callumrst/OpenHaldex-T4/Documents & Notes/92d4ecdb-a1d0-4684-9f06-b1b2331b5a30.jpg

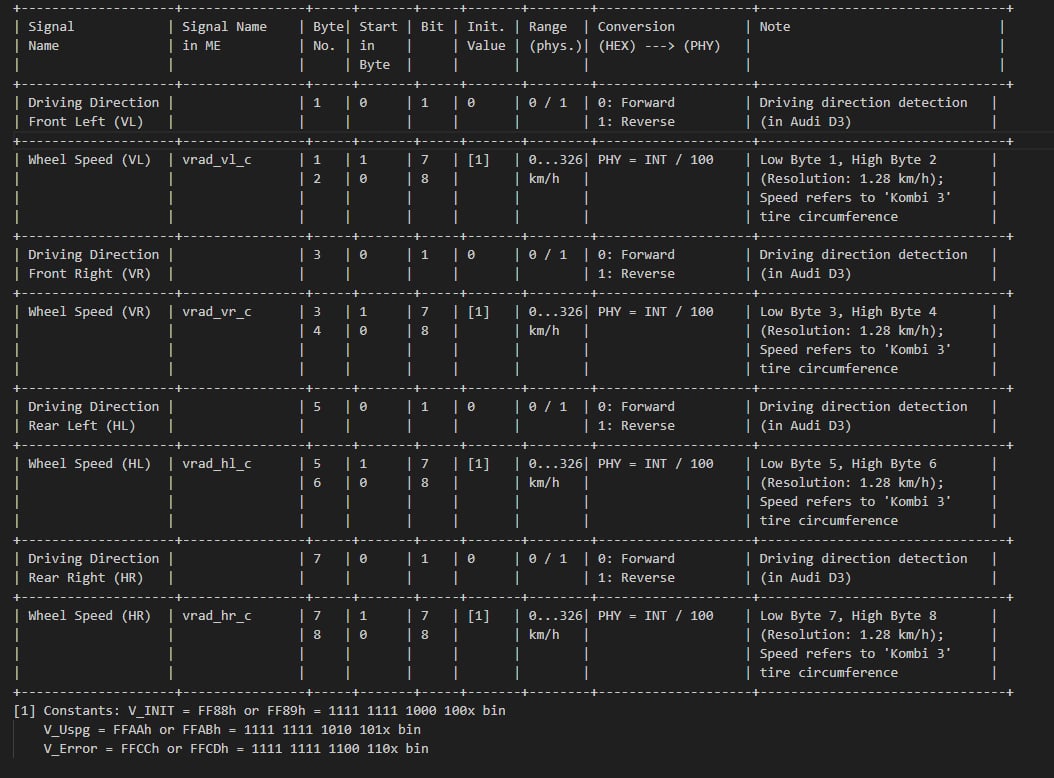
Documents & Notes/92d4ecdb-a1d0-4684-9f06-b1b2331b5a30.jpg
