callumrst/OpenHaldex-T4/README.md

# OpenHaldex - V3 dev fork

This is purely a development fork - do not upload to your Haldex Controller.
