callumrst/OpenHaldex-T4/Documents & Notes/IMG_9825.thumb.png.15f37aaaf69d263c4d689f1573d7c5fc.png

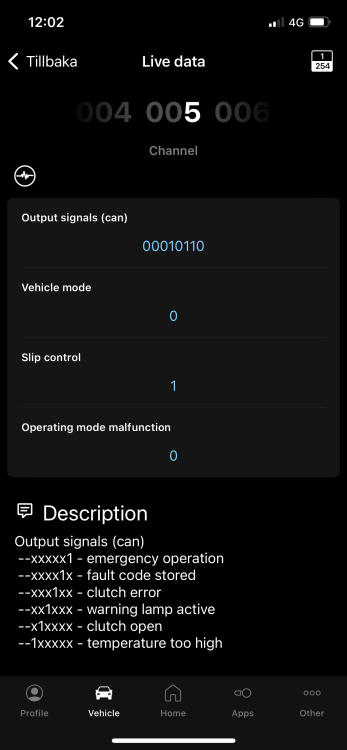
Documents & Notes/IMG_9825.thumb.png.15f37aaaf69d263c4d689f1573d7c5fc.png
