callumrst/OpenHaldex-T4/Documents & Notes/MKV GTI CAN-BUS data.xlsx

Sheet: Example Traces
Action Sample Time | Relative time |  | ID (hex) | DLC | D0 B1 | D1 B2 | D2 B3 | D3 B4 | D4 B5 | D5 B6 | D6 B7 | D7 B8 | Comments |  | Protocol decode
Radio off to on
0.006 | 0.000 | 680 | 1 | A3 |  |  |  |  |  |  |  |  |  | Channel parameters
0.018 | 0.012 | 681 | 6 | A1 | 04 | 8A | FF | 32 | FF |  |  | ASCII: 2 | 04 | number of packets until ACK
1.495 | 1.489 | 680 | 1 | A3 |  |  |  |  |  |  |  |  | 0x8AFF, 0x32FF | TP2.0 timming parameters
1.496 | 1.490 | 681 | 6 | A1 | 04 | 8A | FF | 32 | FF |  |  | ASCII: 2
2.899 | 2.893 | 680 | 8 | 20 | 02 | 70 | 52 | 12 | 41 | 75 | 64 | ASCII: pR Aud | 0x52 | Radio (requester) wants to
2.901 | 2.895 | 680 | 8 | 21 | 69 | 6F | 00 | 00 | 00 | 00 | 00 | ASCII:!io | 0x02 70 | add menu to MFA+
2.902 | 2.896 | 680 | 1 | A3 |  |  |  |  |  |  |  |  | 0x12 | in the middle segment | (110x91 pixels)
2.925 | 2.919 | 680 | 7 | 12 | 00 | 00 | 00 | 00 | 00 | 00 |  | ASCII: |  | with title 'Audio'
2.946 | 2.940 | 681 | 6 | A1 | 04 | 8A | FF | 32 | FF
2.974 | 2.968 | 681 | 1 | B3
3.01 | 3.004 | 681 | 5 | 10 | 23 | 00 | 00 | 00 |  |  |  | ASCII: # | 0x23 0x00 | reply with screen area ID, 0x00 in this example
3.01 | 3.004 | 680 | 1 | B1
4.381 | 4.375 | 680 | 1 | A3
4.416 | 4.410 | 681 | 6 | A1 | 04 | 8A | FF | 32 | FF
30.921 | 30.915 | 680 | 1 | A3
30.931 | 30.925 | 681 | 6 | A1 | 04 | 8A | FF | 32 | FF
32.014 | 32.008 | 680 | 1 | A3
32.025 | 32.019 | 681 | 6 | A1 | 04 | 8A | FF | 32 | FF
Switching to the Audio page
0.475 | 0.000 | 681 | 3 | 19 | 2A | 00 |  |  |  |  |  |  |  | req to jump to menu channel/area ID 00
0.476 | 0.001 | 680 | 1 | BA
0.496 | 0.021 | 681 | 5 | 1A | 23 | 00 | 01 | 00 |  |  |  |  |  | request to send data in area ID 00
0.498 | 0.023 | 680 | 1 | BB
0.512 | 0.037 | 680 | 8 | 23 | 09 | 00 | 60 | 09 | 00 | 00 | 00 |  | 0x09 0x00 | draw into the screen area ID, 0x00 in this example |  |  | clear screen
0.521 | 0.046 | 680 | 8 | 24 | 00 | 00 | 6E | 00 | 5B | 00 | 61 |  | 0x60 | graphic rectangle block follows after params |  | 0x09 | 09 bytes until end of array
0.531 | 0.056 | 680 | 8 | 25 | 06 | 08 | 00 | 6D | 00 | 00 | 00 |  |  | dimension of rectangle: 110x91 (0x006E x 0x005B) | (110x91 pixels) |  | draw text
0.543 | 0.068 | 680 | 8 | 06 | 61 | 0F | 10 | 00 | 37 | 00 | 1E |  | 0x61 | ASCII block follows after params |  | 0x0F | 15 bytes until end of array
0.549 | 0.074 | 681 | 1 | B7 |  |  |  |  |  |  |  |  |  |  |  |  | draw text
0.553 | 0.078 | 680 | 8 | 27 | 00 | 31 | 30 | 33 | 2E | 31 | 20 | ASCII:'103.1 |  | "103.1 MHz"
0.564 | 0.089 | 680 | 8 | 28 | 4D | 48 | 7A | 61 | 0A | 00 | 00 | ASCII:(MHza | 0x61 | ASCII block follows after params |  | 0x0A | 10 bytes until end of array
0.575 | 0.100 | 680 | 8 | 29 | 03 | 00 | 47 | 00 | 46 | 4D | 02 | ASCII:)G FM | 0x46 4D | "FM" |  |  | draw text
0.585 | 0.110 | 680 | 3 | 1A | 32 | 08 |  |  |  |  |  | ASCII:2 | 0x32 | "2" |  | 0x08 | end of block arrays
0.593 | 0.118 | 681 | 1 | BB
0.604 | 0.129 | 681 | 4 | 1B | 27 | 00 | 01 |  |  |  |  | ASCII:' | 0x27 00 01 | screen area displayed successfully
0.606 | 0.131 | 680 | 1 | BC
0.682 | 0.207 | 680 | 1 | A3
0.691 | 0.216 | 681 | 6 | A1 | 04 | 8A | FF | 32 | FF
1.766 | 1.291 | 680 | 1 | A3
1.774 | 1.299 | 681 | 6 | A1 | 04 | 8A | FF | 32 | FF
Changing radio stations on the audio page
29.316 | 0.000 | 680 | 8 | 23 | 09 | 00 | 60 | 09 | 00 | 00 | 00 | ASCII:# ` | 0x09 0x00 | draw into the screen area ID, 0x00 in this example |  |  | clear screen
29.327 | 0.011 | 680 | 8 | 24 | 00 | 00 | 6E | 00 | 5B | 00 | 61 | ASCII:$ n [ a | 0x60 | graphic rectangle block follows after params |  | 0x09 | 09 bytes until end of array
29.338 | 0.022 | 680 | 8 | 25 | 06 | 08 | 00 | 6D | 00 | 00 | 00 |  |  | dimension of rectangle: 110x91 (0x006E x 0x005B) | (110x91 pixels) |  | draw text
29.35 | 0.034 | 680 | 8 | 06 | 61 | 0F | 10 | 00 | 37 | 00 | 1E |  | 0x61 | ASCII block follows after params |  | 0x0F | 15 bytes until end of array
29.36 | 0.044 | 681 | 1 | B7 |  |  |  |  |  |  |  |  |  |  |  |  | draw text
29.37 | 0.054 | 680 | 8 | 27 | 00 | 31 | 30 | 32 | 2E | 33 | 20 | ASCII:' 102.3 |  | "102.3 MHz"
29.381 | 0.065 | 680 | 8 | 28 | 4D | 48 | 7A | 61 | 0A | 00 | 00 | ASCII:(MHza | 0x61 | ASCII block follows after params |  | 0x0A | 10 bytes until end of array
29.392 | 0.076 | 680 | 8 | 29 | 03 | 00 | 47 | 00 | 46 | 4D | 02 | ASCII:) G FM | 0x46 4D | "FM" |  |  | draw text
29.402 | 0.086 | 680 | 3 | 1A | 32 | 08 |  |  |  |  |  | ASCII: 2 | 0x32 | "2" |  | 0x08 | end of block arrays
29.414 | 0.098 | 681 | 1 | BB
29.424 | 0.108 | 680 | 1 | A3
29.436 | 0.120 | 681 | 6 | A1 | 04 | 8A | FF | 32 | FF
29.448 | 0.132 | 681 | 4 | 1D | 27 | 00 | 01 |  |  |  |  |  | 0x27 00 01 | screen area displayed successfully
29.456 | 0.140 | 680 | 1 | BE
29.555 | 0.239 | 680 | 8 | 2B | 09 | 00 | 60 | 09 | 00 | 00 | 00 | ASCII:+ ` |  |  |  |  | clear screen
29.565 | 0.249 | 680 | 8 | 2C | 00 | 00 | 6E | 00 | 5B | 00 | 61 | ASCII:, n [ a |  | dimension of rectangle: 110x91 (0x006E x 0x005B) | (110x91 pixels) |  | draw text
29.576 | 0.260 | 680 | 8 | 2D | 06 | 08 | 00 | 6D | 00 | 00 | 00 | ASCII:- m
29.587 | 0.271 | 680 | 8 | 0E | 61 | 0F | 10 | 00 | 37 | 00 | 1E | ASCII: a 7
29.598 | 0.282 | 681 | 1 | BF
29.608 | 0.292 | 680 | 8 | 2F | 00 | 31 | .. | 33 | 2E | 31 | 20 | ASCII:/ 103.1 |  |  |  | 0x0A | 10 bytes until end of array
29.62 | 0.304 | 680 | 8 | 20 | 4D | 48 | .. | 61 | 0A | 00 | 00 | ASCII: MHza |  |  |  |  | draw text
29.63 | 0.314 | 680 | 8 | 21 | 03 | 00 |  | 00 | 46 | 4D | 02 | ASCII:! G FM
29.642 | 0.326 | 680 | 3 | 12 | 32 | 08 |  |  |  |  |  | ASCII: 2 |  |  |  | 0x08 | end of block arrays
29.652 | 0.336 | 681 | 1 | B3 |  |  |  |  |  |  |  | ASCII:
29.685 | 0.369 | 681 | 4 | 1E | 27 | 00 | 01 |  |  |  |  | ASCII: ' | 0x27 00 01 | screen area displayed successfully
29.695 | 0.379 | 680 | 1 | BF |  |  |  |  |  |  |  | ASCII:
29.825 | 0.509 | 680 | 8 | 23 | 09 | 00 | 60 | 09 | 00 | 00 | 00 | ASCII:# ` |  |  |  |  | clear screen
29.836 | 0.520 | 680 | 8 | 24 | 00 | 00 | 6E | 00 | 5B | 00 | 61 | ASCII:$ n [ a |  |  |  |  | draw text
29.847 | 0.531 | 680 | 8 | 25 | 06 | 08 | 00 | 6D | 00 | 00 | 00 | ASCII:% m
 |  |  |  |  | ... | ... | ... | ... | ... | ...

Sheet: ASCII-hex conversion table
ASCII | Hex | ASCII | Hex | Comments
A | 0x41 | a | 0x61
B | 0x42 | b | 0x62
C | 0x43 | c | 0x63
D | 0x44 | d | 0x64
E | 0x45 | e | 0x65
F | 0x46 | f | 0x66
G | 0x47 | g | 0x67
H | 0x48 | h | 0x68
I | 0x49 | i | 0x69
J | 0x4A | j | 0x6A
K | 0x4B | k | 0x6B
L | 0x4C | l | 0x6C
M | 0x4D | m | 0x6D
N | 0x4E | n | 0x6E
O | 0x4F | o | 0x6F
P | 0x50 | p | 0x70
Q | 0x51 | q | 0x71
R | 0x52 | r | 0x72
S | 0x53 | s | 0x73
T | 0x54 | t | 0x74
U | 0x55 | u | 0x75
V | 0x56 | v | 0x76
W | 0x57 | w | 0x77
X | 0x58 | x | 0x78
Y | 0x59 | y | 0x79
Z | 0x5A | z | 0x7A
0 | 0x30
1 | 0x31
2 | 0x32
3 | 0x33
4 | 0x34
5 | 0x35
6 | 0x36
7 | 0x37
8 | 0x38
9 | 0x39
EOL | 0x60 0x09 |  |  | NOT, 60 09 represents 09 bytes of graphic data to be shown on Instrument Cluster
" " | 0xA0
"." | 0x2E
x

Sheet: Convenience
 | ID | DLC | Period |  | Affects device | Comment
385 | 181 | 2 | 20 | XY ZZ | TRUE | Window Buttons | X | Pass WIndows | Y | Driver WIndow | ZZ | Rear Doors
 | - | - | - | - | - | - | 1 | Up | 1 | Up
 | - | - | - | - | - | - | 2 | Auto up | 2 | Auto up
 | - | - | - | - | - | - | 4 | Down | 4 | Down
 | - | - | - | - | - | - | 8 | Auto down | 8 | Auto down
649 | 289 | 4 | 20 | 00 XX 00 00 | TRUE | Cruise Control | XX | Buttons
 | - | - | - | - | - | - | 0 | Off | 00000000
 | - | - | - | - | - | - | 1 | On | 00000001
 | - | - | - | - | - |  | 9 | Resume | 00001001
 | - | - | - | - | - | - | 5 | Set | 00000101
657 | 291 | 5 | 40 | 00 XX YY 00 00 | TRUE | Locks | XX |  | YY
 | - | - | - | - | - | - | AA | Locks doors | 04 | Unlocks trunk
 | - | - | - | - | - | - | 55 | Unlocks doors
705 | 2C1 | 5 (6?) | 100 | XX 00 00 00 00 | TRUE | Turn Signal Control | XX
 | - | - | - | - | - | - | 00010000 | Left
 | - | - | - | - | - | - | 00100000 | Right
 | - | - | - | - | - | - | 01000000 | HB forward | 40
 | - | - | - | - | - | - | 10000000 | HB back | 80
707 | 2C3 | 1 | 100 | XX 00 00 | FALSE | Ignition | XX
 | - | - | - | - | - | - | 00010000 | Key out
 | - | - | - | - | - | - | 00010001 | Key back, power on
 | - | - | - | - | - | - | 00000111 | Key on
 | - | - | - | - | - | - | 00000011 | Between on and start
 | - | - | - | - | - | - | 00001011 | Start
 | - | - | - | - | - | Diagnostic cable ID's
764 | 2FC |  |  |  |  | Steering
768 | 300 |  |  |  |  | CCM
784 | 310 |  |  |  |  | Driver Door
786 | 312 |  |  |  |  | Pass Door
808 | 328 |  |  |  |  | Conveniece
825 | 339 |  |  |  |  | Central Electronic
826 | 33A |  |  |  |  | Aux Heating
829 | 33D |  |  |  |  | HVAC
 | - | - | - | - |  | - | fsm library | (XX*(2^8)+(YY-1))/190 | 02 | Reverse
 | - | - | - | - |  | - |  |  | 00 | Forward
859 | 35B | 8 | 100 | 00 AA XX YY ZZ BB DD CC | ? | RPM, Oil temp, water Temp | XX | RPM | (YY*0.75)-64 |  | ZZ |  | Pedals | BB
 | - | - | - | - |  | - |  | (XX*(2^8)+AA)/4 |  | Water temp | ZZ | Oil temp | Clutch out | 00001000
 | - | - | - | 192 | 9 |  |  | 12290.25 |  |  |  | - | Clutch in | 00000000
 | - | - | - | - | - | - | - | - | - | - | - | - | in | 00001011
 | - | - | - | - | - | - | - | - | - | - | - | - | both | 00000011
897 | 381 | 6 | 100 | XX YY ZZ AA BB CC | TRUE | Driver Door |  | Lock | YY | Window Switch | ZZ | Windows Position | Window Status | AA | BB | Trunk/fuel | CC | Limits
 | - | - | - | - | - | - | 0000000X | Door open/closed | 00010000 | Window up | 00-C8 | Position | Open, not moving | 0 | 0 | Nothing | 1 | Top limit |  |  | 8 | Normal
 | - | - | - | - | - | - | 000000X0 | Door locked/unlocked | 100000 | Window auto up |  |  | Moving up | 1 | 1 | Fuel door release | 10 | Bottom limit |  |  | A | Pinch Detected
 | - | - | - | - | - | - | 00000100 | Lock pressed | 01000000 | Window down |  |  | Moving down | 10 | 10 | Trunk Unlock
 | - | - | - | - | - | - | 00001000 | ? | 10000000 | Window auto down |  |  | Rear Window lock? | 100 | 01000000 | Mirror heater Active?
913 | 391 | 3 | 20 | XX YY ZZ | TRUE | Key Fob | XX |  | YY |  | ZZ
 | - | - | - | - |  | - | 0 | Nothing | 0 | Nothing |  | Nothing
 | - | - | - | - |  | - | AA | Window down | 80 | Lock doors |  | Open sunroof?
 | - | - | - | - |  | - | 55 | Window up | 4 | Unlock doors |  | Close sunroof?
917 | 395 | 1 | 50 | XY | x does | Anti Theft | X |  | Y
 | - | - | - | - | - | - | 2 | ? | 1 | unlock
 | - | - | - | - | - | - | A | ? | 2 | lock
 | - | - | - | - | - | - | 8 | flash lights
949 | 3B5 | 6 | 100 | XX YY ZZ AA 00 CC | TRUE | Pass Door | xx | Lock | YY | Window Switch | ZZ | Window Position | Window Status | AA | CC | Limits
 | - | - | - | - | - | - | 0000000X | Door open/closed | 00010000 | Window up | 00-C8 | Position | Open, not moving | 0 | 1 | Top limit |  |  | 8 | Normal
 | - | - | - | - | - | - | 000000X0 | Door locked/unlocked | 100000 | Window auto up |  |  | Moving up | 1 | 10 | Bottom limit |  |  | A | Pinch Detected
 | - | - | - | - | - | - | 00000100 | Lock pressed | 01000000 | Window down |  |  | Moving down | 10
 | - | - | - | - | - | - | 10 | Unlock Pressed |  |  |  |  | ? | 1000
961 | 3C1 | 6 | 200 | XX 00 00 00 00 00 | FALSE | Steering | XX | Steering Wheel torque
963 | 3C3 | 8 | 100 | XX 00 00 00 00 00 00 00 | FALSE | Steering | XX | Steering Wheel Position
849 | 351 | 8 | ? | AA BB XX YY 00 00 00 00 | ? | Vehicle Speed | XX YY | Speed | AA | Direction
992 | 3E0 | 8 | ? | 02 00 10 00 00 00 80 00 | ? | ? | only appeared once
993 | 3E1 | 8 | 100 | XX 00 YY ZZ 00 00 AA | ? | Heater Controls? | XX |  | ZZ | AC? | ZZ | temp? | Temp? | AA
 | - | - | - | - | - | - | 20 | ? |  |  |  |  | HI | 100
 | - | - | - | - | - | 0000010 | 2 | Full hot selected |  |  |  |  | LOW | 10000000
 | - | - | - | - | - | - | 6 | rear def pressed
1136 | 470 | 5 | 50 | YY XX 00 00 00 | TRUE | Door Contacts | XX | Contacts | YY
 | - | - | - | - | - | - | 00 | Closed | 20 | Reverse gear selected
 | - | - | - | - | - | - | 01 | Drivers open
 | - | - | - | - | - | - | 02 | Pass open
 | - | - | - | - | - | - | 04 | Rear Drivers open
 | - | - | - | - | - | - | 08 | Rear pass open
 | - | - | - | - | - | - | 20 | Tailgate open
 | - | - | - | - | - | - | 10 | Hood open
1319 | 527 | 8 | 200 | 00 00 00 00 XX YY ZZ 00 | ? | Outside Temp | xx | Front Bumper? | YY | Roof? | ZZ | Rear bumper?
 | - | - | - | - | - | - | dec | (XX/2)-50 | dec | (XX/2)-50 | dec | (XX/2)-50
 | - | - | - | - | - | example: | 79 | 10.5
1329 | 531 | 4 | 50 | XX YY 00 00 | TRUE | Lights | XX |  | YY
 | - | - | - | - | - | - | 00000000 | Off | 00000000 | Off |  | 0 |  | 0
 | - | - | - | - | - |  | 00000100 | High beams | 00100001 | Left |  |  |  | 12
 | - | - | - | - | - |  | 00001000 | Fogs | 00010010 | Right |  | 4 |  | 1B
 | - | - | - | - | - |  | 00100000 | Reverse | 00011011 | 4 way |  | 8 |  | 40
 | - | - | - | - | - |  | 01000000 | Left | 01000000 | Brakes |  | 20 |  | 80
 | - | - | - | - | - |  | 10000000 | Right | 10000000 | ? |  | 40 |  | 8
 |  |  |  |  |  |  |  |  | 00001000 | ? |  | 80
1361 | 551 | 1 | 100 | XX | FALSE | Power On | xx
 | - | - | - | - | - | - | 00 | Power off
 | - | - | - | - | - | - | 01 | Power on
1365 | 555 | ? | ? | AA BB XX YY YY ZZ | FALSE | Engine load/boost | AA/XX | Engine Load | YY YY | Boost | ZZ | Oil temp? | Tun timer? | BB
1393 | 571 | 6 | 600 | XX 00 00 00 00 00 | FALSE | Battery | XX | Voltage
 | - | - | - | - | - |  | dec | ((XX/2)+50)/10 | 12.5
 | - | - | - | - | - | example: | 8f | 12.15
1425 | 591 | 8 | 200 | 00 XX 00 00 00 00 00 00 |  | Mirror/tailgate/hood? | XX
 | - | - | - | - | - | - | 00000001 | All locked
 | - | - | - | - | - | - | 00000010 | All unlocked
 | - | - | - | - | - | - | 00000011 | Doors unlocked, trunk unlocked
1432 | 598 | 8 | 100 | XX 00 00 00 00 00 00 00 | FALSE | DCC status | XX = status of DCC + button
 |  |  |  |  |  | Golf 6 ( gti ) DCC suspension | 41 ( 51 ) | DCC mode comfort | (DCC comfort + button pressed)
 |  |  |  |  |  |  | 42 ( 52 ) | DCC mode normal | (DCC normal + button pressed)
 |  |  |  |  |  |  | 43 ( 53 ) | DCC mode sport | (DCC sport + button pressed)
1473 | 5C1 | 1 | 100 | XX | TRUE | Steering Wheel Buttons | XX
 | - | - | - | - | - | - | 00 | None |  |  |  |  | None | 00
 | - | - | - | - | - | - | 06 | Vol up |  |  |  |  | Next track | 02
 | - | - | - | - | - | - | 07 | Vol down |  |  |  |  | Previous track | 03
 | - | - | - | - | - | - | 0A | Menu |  |  |  |  | Vol up | 06
 | - | - | - | - | - | - | 1A | Phone |  |  |  |  | Vol down | 07
 | - | - | - | - | - | - | 22 | Up |  |  |  |  | Back | 29
 | - | - | - | - | - | - | 28 | Down |  |  |  |  | Phone | 1A
 | - | - | - | - | - | - | 2B ??? | OK |  |  |  |  | Up | 22
 | - | - | - | - | - |  | 2B | Mute |  |  |  |  | Down | 23
 |  |  |  |  |  | Wipers | XX
1489 | 5D1 | 2 | 200 | XX YY | TRUE | - | 00000000 |  | YY
 | - | - | - | - | - | - | 00000001 | off | 00000000 | Rear wiper off
 | - | - | - | - | - | - | 00000010 | Normal speed | 00000010 | Rear spray
 | - | - | - | - | - | - | 00000101 | Spray front | 00000101 | Rear wiper on
 | - | - | - | - | - | - | 00001001 | Medium
 | - | - | - | - | - | - | 000X0000 | Fast
 | - | - | - | - | - |  |  | 1=Parked 0=not
 |  |  |  |  |  | Interior Lights | XX
1501 | 5DD | 5 | 100 | 00 YY XX 00 00 | xx does |  |  |  | YY | Int. lights dim amount
 | - | - | - | - |  | - | 00010000 | Controls lock lights | 64 | 0% dimming
 | - | - | - | - | - | - |  |  | 00 | 100% dimmed
1537 | 601 | 1 | 200 | XY | FALSE | Mirror Switch Position | X | Position | Y | Movement
 | - | - | - | - | - | - | 01 | On
 | - | - | - | - | - | 00000000 | 0 | O | 2 | Move up | 00000001
 | - | - | - | - | - | 00101000 | 4 | Defrost | 4 | Move down | 00000010
 | - | - | - | - | - | 00001010 | 1 | L | 1 | Move left | 00000100
 | - | - | - | - | - | 00010100 | 2 | R | 8 | Move right | 00001000
1569 | 621 | 5 | 100 | XX 00 00 YY 00 | FALSE | Cluster Info | XX |  | YY
 |  |  |  |  |  |  | 00000010 | Low fuel
 | - | - | - | - | - | - | 00000100 | Washer fluid
 | - | - | - | - | - | - | 00001000 | Low oil?
 | - | - | - | - | - | - | 00100000 | E brake
1583 | 62F | 4 | 200 | AA XX YY ZZ | FALSE | MFD Display Status | 70 | Not showing | 70 | Normal | 90 | Normal | Reset | 0100 0000
 | - | - | - | - | - | - | 80 | Showing | 20 | Fasten seatbelt | 70 | Settings menu |  | 0010 0000
 |  |  |  |  |  |  |  |  | 40 | Car picture
1589 | 635 | 3 | 200 | XX 00 00 | TRUE | Brightness knob | 64 | 0% dimming |  | 64hex = 100d 100% brightness
 | - | - | - | - | - | - | 00 | 100% dimming
1629 | 65D | 8 | 1000 | 00 XX YY ZZ 00 HH MM SS | - | Time, odometer | 00 | midnight | MM | Still working on this... | SS | Counts up 00-1D (0-29) | ex 00AA27 in dec =43559 | ZZ[0:3]YYXX
 | - | - | - | - | - | - | 10 | 1 oclock |  |  |  | once every 2 seconds
 | - | - | - | - | - | - | 50 | 5 |  | time = (HH>> 4) * 1000 + (HH & 0x0F) * 100 + (MM>> 4) * 10 + (MM & 0x0F);
 | - | - | - | - | - | - | A0 | 10
 | - | - | - | - | - | - | B0 | 11
 | - | - | - | - | - | - | 0 | Off
 | - | - | - | - | - | - | 3 | On
 | - | - |  | - | - |  | 00000011 | Lights on | 00010001 | Left |  | 3 |  | 11
0 |  | 7 | ? | E1 70 66 1C 80 AB 80 |  | ?
17
0 |  | 4 | 100 | 00 A0 F0 50 |  | Air bags?? |  | sending FF FF FF FF
0 |  | 2 | 20 | XY ZZ | TRUE | Window buttons | X | Pass window | Y | Driver window | ZZ | Back doors
0 |  | 7 | 200 | 48 C0 00 10 39 03 10 |  | ?
0 |  | 7 | ? | 48 C0 00 10 28 03 10 |  | MFA+ init
0 |  | 7 | 200 | 20 D0 39 03 D0 04 10 |  | ?
649 | 289 | 4 | 20 | 00 XX 00 00 | TRUE | Cruise control | XX | Buttons
657 | 291 | 5 | 40 | 00 XX YY 00 00 | TRUE | Locks | XX |  | YY
705 | 2C1 | 5 | 100 | XX YY 00 00 00 | TRUE | Turn signal control | XX |  | YY | Windscreen wipers
707 | 2C3 | 1 | 100 | XX 00 00 | FALSE | Ignition state | XX
707 | 2C3 | - | - | - | - | - | 00010000 | Left | 10
764 | 2FC |  |  |  |  | Steering
768 | 300 |  |  |  |  | CCM
784 | 310 |  |  |  |  | Driver door
786 | 312 |  |  |  |  | Pass door
808 | 328 |  |  |  |  | Convenience
825 | 339 |  |  |  |  | Central electronic
826 | 33A |  |  |  |  | Aux heating
829 | 33D |  |  |  |  | HVAC
849 | 351 | 8 | ? | AA BB XX YY 00 00 00 00 | ? | Vehicle speed | XX YY | Speed | AA | Direction
857 | 359 |  |  | ?? ?? ?? ?? ?? ?? ?? AA |  | DSG data | AA | AA
 |  |  |  |  |  |  | 88 = park
 |  |  |  |  |  |  | 70 = reverse
 |  |  |  |  |  |  | 60 = neutral
 |  |  |  |  |  |  | 50 = drive
 |  |  |  |  |  |  | C0 = sport
 |  |  |  |  |  |  | E0 = manual
 |  |  |  |  |  |  | A0 = manual up
 |  |  |  |  |  |  | B0 = manual down
859 | 35B | 8 | 100 | 00 AA XX YY ZZ BB DD CC | ? | RPM, oil temp, water temp | AA XX | RPM | YY |  | ZZ |  | Pedals | BB | CC | Counts up | DD | Fuel Level
897 | 381 | 6 | 100 | XX YY ZZ AA BB CC | TRUE | Driver door | XX | Lock | YY | Window switch | ZZ | Window position | Window status | AA | BB | Trunk/fuel | CC | Limits |  |  | F | Window status
899 | 383 | 3 | 100 | 00 00 00 |  | ?
913 | 391 | 3 | 20 | XX YY ZZ | TRUE | Key fob | XX |  | YY
917 | 395 | 1 | 50 | XY | X does | Anti theft | X |  | Y
949 | 3B5 | 6 | 100 | XX YY ZZ AA 00 CC | TRUE | Pass door | XX | Lock | YY | Window switch | ZZ | Window position | Window status | AA | CC | Limits |  |  | F | Window status
961 | 3C1 | 6 | 200 | XX 00 00 00 00 00 | FALSE | Steering | XX | Steering wheel torque
963 | 3C3 | 8 | 100 | XX 00 00 00 00 00 00 00 | FALSE | Steering | XX | Steering wheel position
992 | 3E0 | 8 | ? | 02 00 10 00 00 00 80 00 | ? | ? |  | Only appeared once
993 | 3E1 | 8 | 100 | XX 00 YY ZZ 00 00 AA | ? | Heater controls? | XX |  | ZZ | AC? | ZZ | temp? | Temp? | AA
995 | 3E3 | 8 | 900 | ? | ? | interior temp?
1024 | 400 | 6 | 400 | XX YY ZZ 00 00 00 |  | Ring bus BCM | XX | Next ID | YY | Status | ZZ | Request
1025 | 401 | 6 | 400 | XX YY ZZ 00 00 00 |  | Convenience controller | ID-400 |  | 000X0000 | Sleep Mode | 2 | Rebuild
1026 | 402 | 6 | 400 | XX YY ZZ 00 00 00 |  | Left front door | of the |  | 0000000X | Active | 80 | Login
1027 | 403 | 6 | 400 | XX YY ZZ 00 00 00 |  | Right front door | next |  | 000000X0 | Init | X0000000 | Learn
1028 | 404 | 6 | 400 | XX YY ZZ 00 00 00 |  | Left rear door | device |  | 00010001 | 11 = Active, Sleep Mode | 10000000 | 80 = learn
1029 | 405 | 6 | 400 | XX YY ZZ 00 00 00 |  | Right rear door | in the |  | 00000001 | 01 = Active, Normal Mode
1032 | 408 | 6 | 400 | XX YY ZZ 00 00 00 |  | Cluster | ring. |  | 00000010 | 02 = Inactive, Initialization
1034 | 40A |  |  |  |  | Steering Module
1035 | 40B | 6 | 400 | XX YY ZZ 00 00 00 |  | Gateway
1036 | 40C | 6 | 400 | XX YY ZZ 00 00 00 |  | HVAC
1037 | 40D |  |  |  |  | PDC
1038 | 40E | 6 | 400 | XX YY ZZ 00 00 00 |  | PTC Heater
1066 | 42A
1081 | 439 |  |  |  |  | Radio?
1111 | 457 | 3 | 100 | 01 00 00 | ? | ?
1136 | 470 | 5 | 50 | YY XX 00 00 00 | TRUE | Door contacts | XX | Contacts | YY
1136 | 470 | 5 | 50 | YY XX 00 00 00 | FALSE | Door Contacts | XX | Contact | YY
1209 | 4B9 |  |  |  |  | Rear Driver door Status
1213 | 4BD |  |  |  |  | Rear Passenger door Status
1232 | 4D0 | X | X | X | ? | Contains menu structures
1233 | 4D1 | Z | Z | Z | ? | Contains menu structures
1235 | 4D3
1281 | 501 |  |  |  |  | Mirror movement
1319 | 527 | 8 | 200 | 00 00 00 00 XX YY ZZ 00 | ? | Outside temp | XX | Front bumper? | YY | Roof? | ZZ | Rear bumper?
1329 | 531 | 4 | 50 | XX YY 00 00 | TRUE | Lights | XX |  | YY |  | 00 00 | Level sensors?
1329 | 531 | 4 | 50 | XX YY 00 00 | True? |  | XX |  | YY
1349 | 545 |  |  |  |  | Reverse, PDC, ???
1361 | 551 | 1 | 100 | XX | FALSE | Power on | XX
1365 | 555 | ? | ? | AA BB XX YY YY ZZ | FALSE | Engine load/boost | AA/XX | Engine load | YY YY | Boost | ZZ | oil temp? | Run timer? | BB
1393 | 571 | 6 | 600 | XX 00 00 00 00 00 | FALSE | Battery | XX | Voltage
1397 | 575 | 2 | 200 | XX |  | Ignition | XX | key pos.
1425 | 591 | 8 | 200 | 00 XX 00 00 00 00 00 00 |  | Mirror/tailgate/hood? | XX
1473 | 5C1 | 1 | 100 | XX | TRUE | Steering wheel buttons | XX |  |  | Golf MK6 | 1 | 4 | 12 buttons | XX 00 00 60
1489 | 5D1 | 2 | 200 | XX YY | TRUE | Wipers | XX |  | YY
1489 | 5D1 | - | - | - | - | Wipers | 00000000 | off | 00000000 | Rear wiper off
1501 | 5DD | 5 | 100 | 00 YY XX 00 00 | XX does | Interior lights | XX |  | YY | Int lights dim amount
1507 | 5E3 |  |  |  |  | Temperatures AC? |  |  |  |  |  |  | OK | 28
1519 | 5EF | 3 | 200 | XX YY ZZ | FALSE | AUX(PTC) heater | XX |  | YY | Current draw | ZZ | Output
1537 | 601 | 1 | 200 | XY | FALSE | Mirror switch position | X | Position | Y | Movement
1537 | 601 | - | - | - | - | - | 00 | Off
1550 | 60E | 2 | 1100 | 88 01 |  | ?
1569 | 621 | 5 | 100 | XX 00 00 YY 00 | FALSE | Cluster info | XX |  | YY | Fuel light?
1583 | 62F | 4 | 200 | AA XX YY ZZ | FALSE | MFD Display status | XX | Compass | YY | Middle | ZZ |  | MFD Buttons | AA
1589 | 635 | 3 | 200 | XX 00 00 | TRUE | Brightness knob | XX | Dash brightness
1617 | 651 | 8 | 200 | 00 00 00 | ? | ?
1619 | 653 | 3 | 540 | 84 02 84 | ? | Language / Area | Byte 1 (Example 0x84) | Byte 2 (Example 0x02) Language. | Byte 3 (distance unit)Kilometers or Miles | In this given case it's a UK car with english language and Miles displayed in cluster and Nav unit.
1621 | 655 | 8 | 540 | F5 00 E0 0F 5C 00 10 40 | ? | Central Gateway
1629 | 65D | 8 | 1000 | 00 XX YY ZZ 00 HH MM SS | ? | Time, odometer | HH | Hours | MM | Minutes | SS | Seconds | Odometer | XX YY ZZ
1631 | 65F | 8 | 200 | X | FALSE | VIN
1633 | 661 | 8 | 1000 | 0X 00 00 00 00 00 00 00 | FALSE | Radio power | X
1689 | 699 |  |  |  |  | Radio?
1721 | 6B9 |  |  |  |  | Radio?
624 | zerdeçal | 7 | ? | ED 9B 4E 2E 6A 64 1F |  | ?
 |  | - | - | - | - | - | 00100000 | Right | 20
 |  | - | - | - | - | - | 00001000 | ? | 10000000 | Window auto down |  |  | ? | 100
 |  | - | - | - | - | - | 04 | Rear drivers open
 |  | - | - | - | - | - | 08 | Rear pass open
 |  |  |  |  |  |  |  | Unlocks doors and flashes the 4 ways
 |  |  |  |  |  |  | 1000 0000 |  | Low?
 |  |  |  |  |  | reverse example: | 24 | 94
 |  |  |  |  |  |  | 0010 0000 | Mirror heater?
 |  |  |  |  |  |  |  |  |  |  | ID | DLC |  | DATA
 |  |  |  |  |  |  |  |  |  |  |  |  | Mute | 2B
 |  |  |  |  |  |  | 10110 | ebrake/low fuel |  |  |  |  | MFD Previous screen | 09
 |  |  |  |  |  |  |  |  |  |  |  |  | MFD Next screen | 0A
 |  |  |  |  |  |  | 0x80=ignition on | 0x02 = english | Is a 1:1 Copy of Byte 1
 |  |  |  |  |  |  | 0x01=Europe | 0x01 = german
 |  |  |  |  |  |  | 0x04 = UK | 0x03 = french
 |  |  |  |  |  |  | In this example:Ignition ON / UK setup
 |  |  |  |  |  |  | 50 | 9pm
 |  |  |  |  |  |  | d0 | 1pm

Sheet: Sheet1
Definition nach Lastenheft 'Übertragungsmodul für ESP':
Einerkomplement des Ergebnisses der 8 Bit Addition von Byte 1, 2, 3, 4 und 6.
Prüfsumme (Lenkwinkel 1)
hex | dec
20 | 32 | 00100000 | 11100000 | 224 |  | a
0 | 0 | 00000000 | 0 | 0 |  | b
0 | 0 | 00000000 | 0 | 0 |  | c
0 | 0 | 00000000 | 0 | 0 |  | d
80 | 128 | 10000000 | 10000000 | 128 |  | e
60 | 96 | 01100000 | 10100000 | 160 |  | f
0 | 0 | 00000000 | 0 | 0 |  | g
80 | 128 |  |  | 384 | calc result | h
CF |  |  |  |  | act result | compliment of a, b, c, d + f
207 | 127 | 7F

Sheet: Infotainment
d | DLC | Period | Data | Comment
351 | 8 | ? | AA BB XX YY 00 00 00 00 | ? | Vehicle speed | XX YY | Speed | AA | Direction
- | - | - | - |  | - |  | (XX*(2^8)+(YY-1))/190 | 02 | Reverse
- | - | - | - |  | - |  |  | 00 | Forward
- | - | - | - | Ring bus | XX | Next ID | YY | Status | ZZ | Request
42B | 6 | 400 | XX YY ZZ 00 00 | Cluster | ID-420 of the next device in the ring |  | 1 | Normal | 2 | Rebuild
434 | 6 | 400 | XX YY ZZ 00 00 | HVAC |  |  | 11 | Sleep | 80 | Login
435 | 6 | 400 | XX YY ZZ 00 00 | MDI Interface "Media IN"
436 | 6 | 400 | XX YY ZZ 00 00 | Navigation System
439 | 6 | 400 | XX YY ZZ 00 00 | radio |  |  | 2 | Ring rebuild
43A | 6 | 400 | XX YY ZZ 00 00 | Bluetooth / Telephone
680 | varies from 1 to 8 |  |  | Channel for Communication Radio to Cluster. | Even if a Nav System is installed the Radio Communication uses id 680 and 681
681 | varies from 1 to 8 |  |  | Channel for Communication Cluster to Radio.
682 | varies from 1 to 8 |  |  | Channel for Communication Navigation System to Cluster.
683 | varies from 1 to 8 |  |  | Channel for Communication Cluster to Navigation System.
684 | varies from 1 to 8 |  |  | Channel for Communication Telephone/bluetooth to Cluster.
685 | varies from 1 to 8 |  |  | Channel for Communication Cluster to Telephone/bluetooth.
688 |  | N/A | A3 | MFD to Compass | Flow control frames
689 | 6 | 500 | 0X YY 8A FF 32 FF | Compass info to MFD | X |  | YY
 |  |  |  |  | 0 Single |  | Length of data
 |  |  |  |  | 1 First Frame
 |  |  |  |  | 2 Consecutive Frame
 |  |  |  |  | 3 Flow Control
-
-
-
 |  |  |  |  |  |  | BB | CC | DD | EE | FF |  | - | 7 | 200 | AA BB CC DD EE FF | Audio info on MFD Line 1? (Shirocco 09 /golf6 ) | AA
- |  |  |  |  |  | ASCII Char 1. (Line 1) | ASCII Char 2. (Line 1) | ASCII Char 3. (Line 1) | ASCII Char 4. (Line 1) | ASCII Char 5. (Line 1) | ASCII Char 6. (Line 1)
- | 8 | 200 | AA BB CC DD EE FF GG | Audio info on MFD Line 2??? |  | AA | BB | CC | DD | EE | FF | GG
621 | 1 | 200? | 0 | Display Init ?

Sheet: Drivetrain
Tested on vehicle | ID | DLC | Period | Structure | Comment
Audi A3 8P | 0x520 | 8 | 200mS | 00 00 00 00 00 XX YY ZZ | Odometer, ( XX + YY*(2^8) + ZZ*(2^16) ) [km]
Audi A3 8P | 0x280 | 8 | 10mS | 00 00 XX YY 00 00 00 00 | RPM ( ( XX + YY*(2^8) ) /4 ) [1/min]
 |  |  | 18 | CB | 4
 |  |  | 24 | 203 | 4
 |  |  | 24 | 203 | 227

Sheet: Other
Temp = (byte 6) / 20-40 (Decimal) |  | Hour | Minute
 |  | 3 | e4
 |  |  |  | =(C4/(2^4)) * 1000 + (C4 & 0x0F) * 100 + (C5/(2^4)) * 10 + (C5 & 0x0F);
 |  |  |  | timeval = (hours>> 4) * 1000 + (hours & 0x0F) * 100 + (minutes>> 4) * 10 + (minutes & 0x0F)
5C1 | 1 | 1 | Change input
5C1 | 1 | 2 | Scan forward
5C1 | 1 | 3 | Scan backward
5C1 | 1 | 6 | Vol up
5C1 | 1 | 7 | Vol down
5C1 | 1 | 0A | Menu
5C1 |  | 1A | Phone
5C1 | 1 | 22 | Arrow up
5C1 | 1 | 23 | Arrow down
5C1 | 1 | 28 | OK
5C1 | 1 | 2B | Mute
5C1 | 1 | 0 | Button
 |  |  | 00 | midnight
 |  |  | 10 | 1 oclock
 |  |  | 50 | 5
 |  |  | 60 | 6
 |  |  | 70 | 7
 |  |  | 80 | 8
 |  |  | 90 | 9
 |  |  | A0 | 10
 |  |  | B0 | 11
http://cs.wikipedia.org/wiki/Volkswagen_Transport_Protocol
0C2 | ESP? |  |  | https://wiki.openstreetmap.org/wiki/VW-CAN
1A0 | ABS?
320
480 fuel? | Fuel level?
65Dh
 | time?
 | 6+7:
 | 6 bit 8 is on and off in seconds
 | Lower 6 bits are always up
 | 7 goes from 00 to 1D (0 .29)
 |  |  |  |  | 1. ASCII char on MFD | 2. ASCII char on MFD | 3. ASCII char on MFD | 4. ASCII char on MFD | 5. ASCII char on MFD | 1. ASCII char on MFD
http://www.volkspage.net/technik/ssp/ssp/SSP_238.pdf
