callumrst/OpenHaldex-T4/Enclosure/HaldexBoxV3.STL

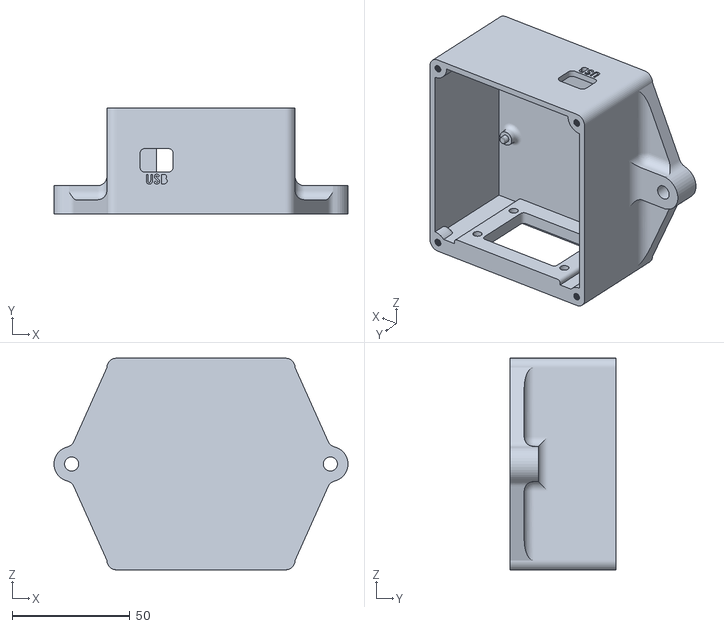
[picture p3: CAD file, 2025-02-12]
Enclosure/HaldexBoxV3.STL
125.0 x 45.0 x 90.0
