callumrst/OpenHaldex-T4/Enclosure/HaldexLidV3.STL

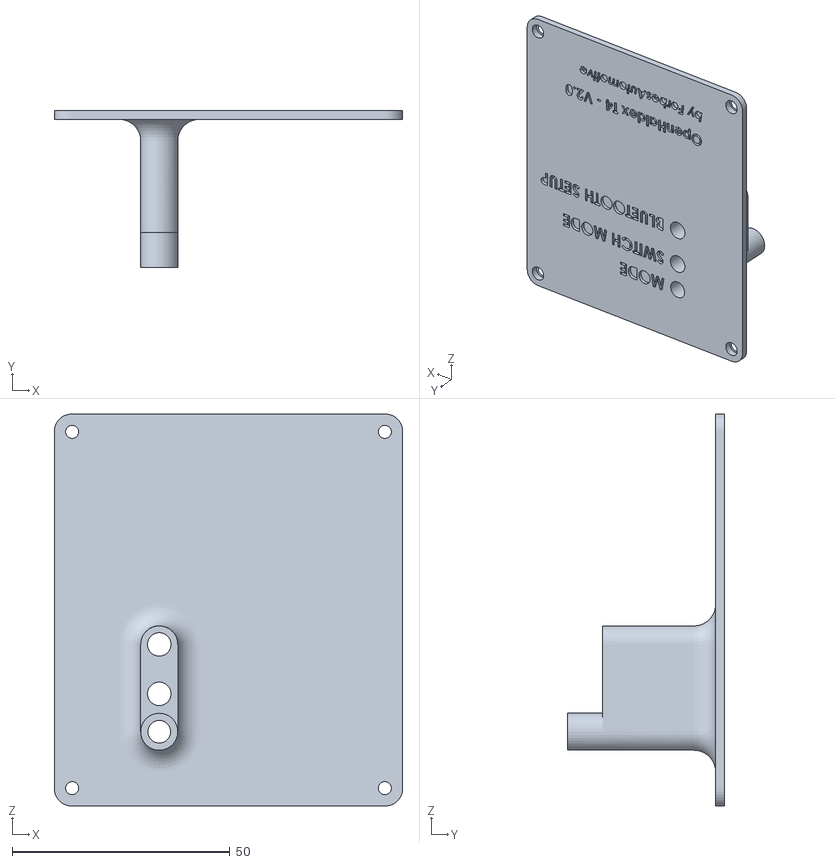
[picture p4: CAD file, 2025-02-12]
Enclosure/HaldexLidV3.STL
80.0 x 36.0 x 90.0
