callumrst/OpenHaldex-T4/Documents & Notes/MKV GTI CAN-BUS data.pdf

## Action Sample Time | Relative time

ID

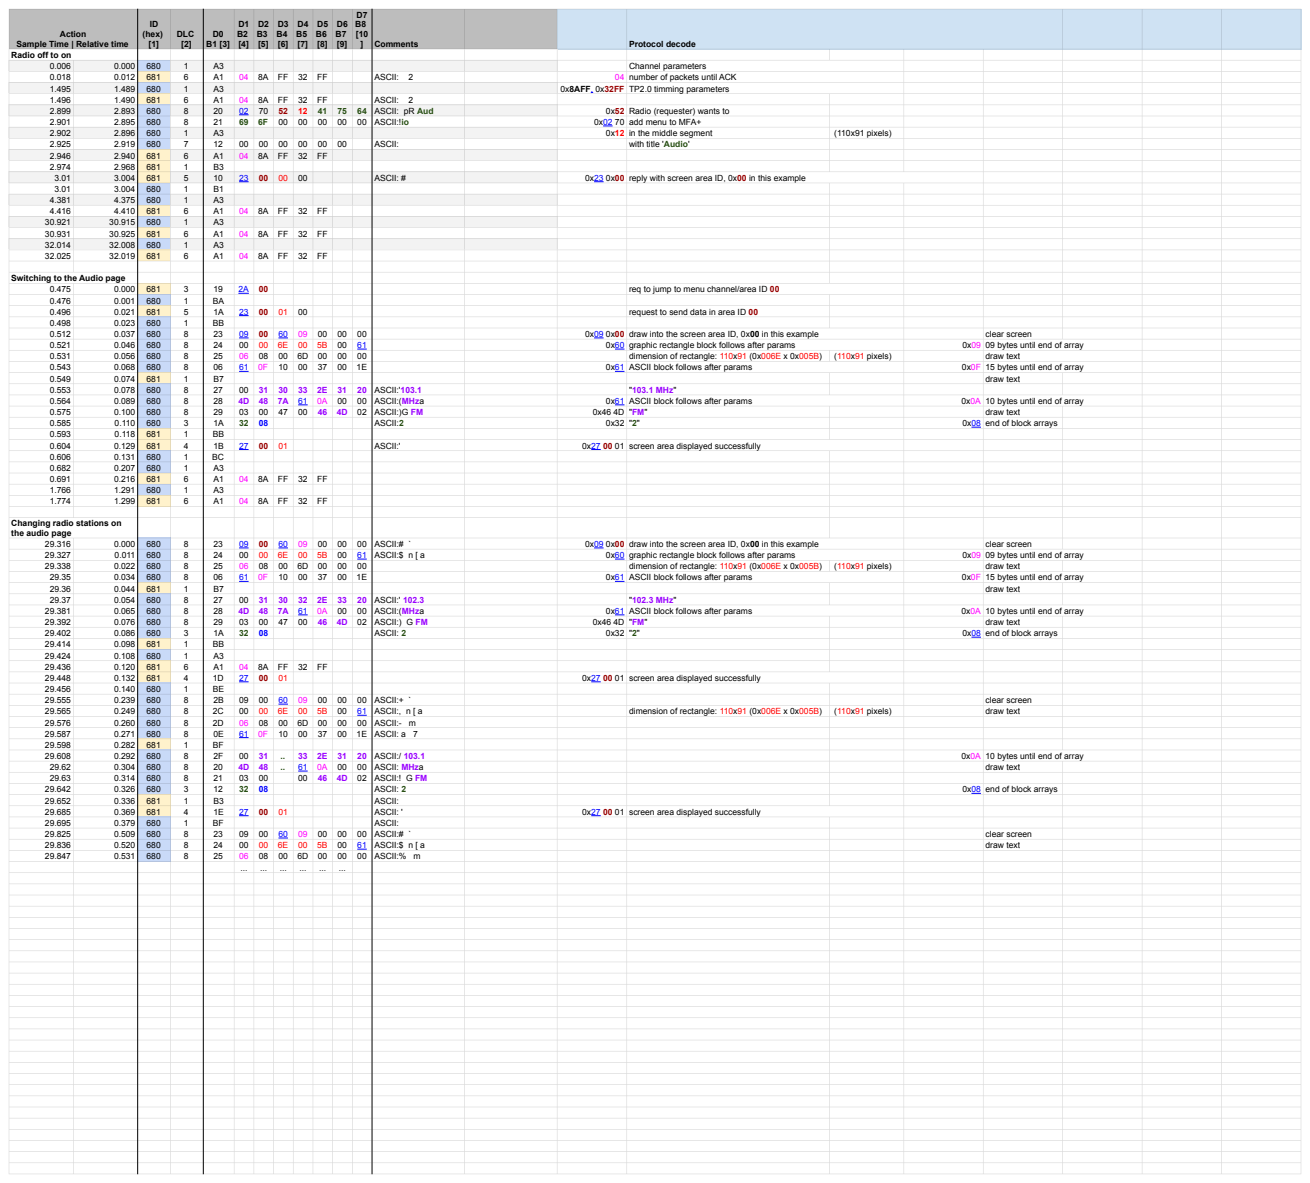
[picture p13: page 1]

0.006 0.000 0.012 | 680 681 | 1 6 | A3 A1 04 8A FF 32 FF | ASCII: 2 | 04 number of packets until ACK Channel parameters 0.018

1.495 1.489 1.490 | 680 681 | 1 6 | A3 A1 04 8A FF 32 FF | ASCII: 2 | 0x8AFF, 0x32FF TP2.0 timming parameters 1.496

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

Switching to the Audio page

Changing radio stations on
the audio page

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

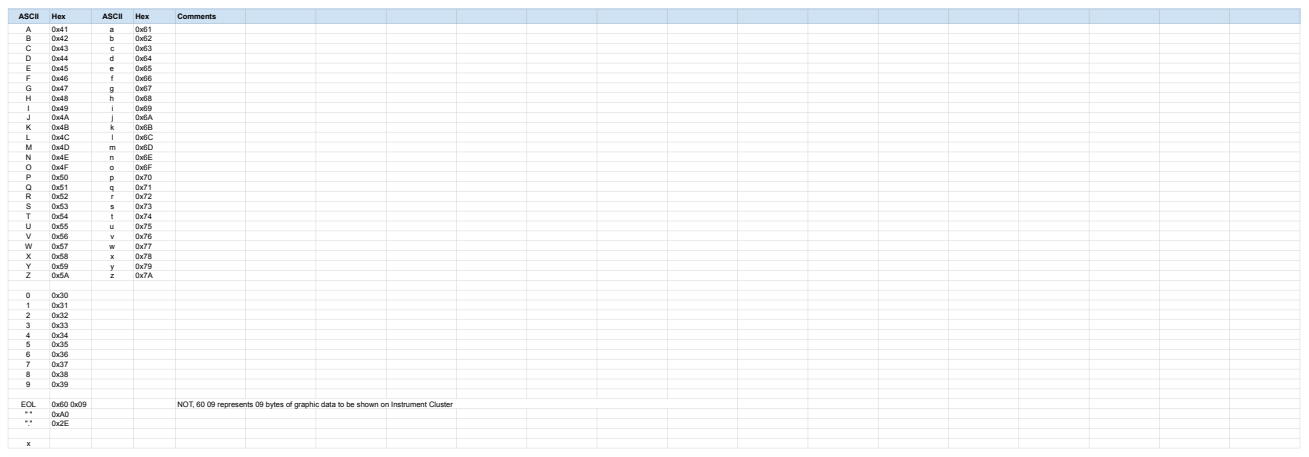
[picture p14: page 2]
EOL; NOT, 60 09 represents 09 bytes of graphic data to be shown on Instrument Cluster

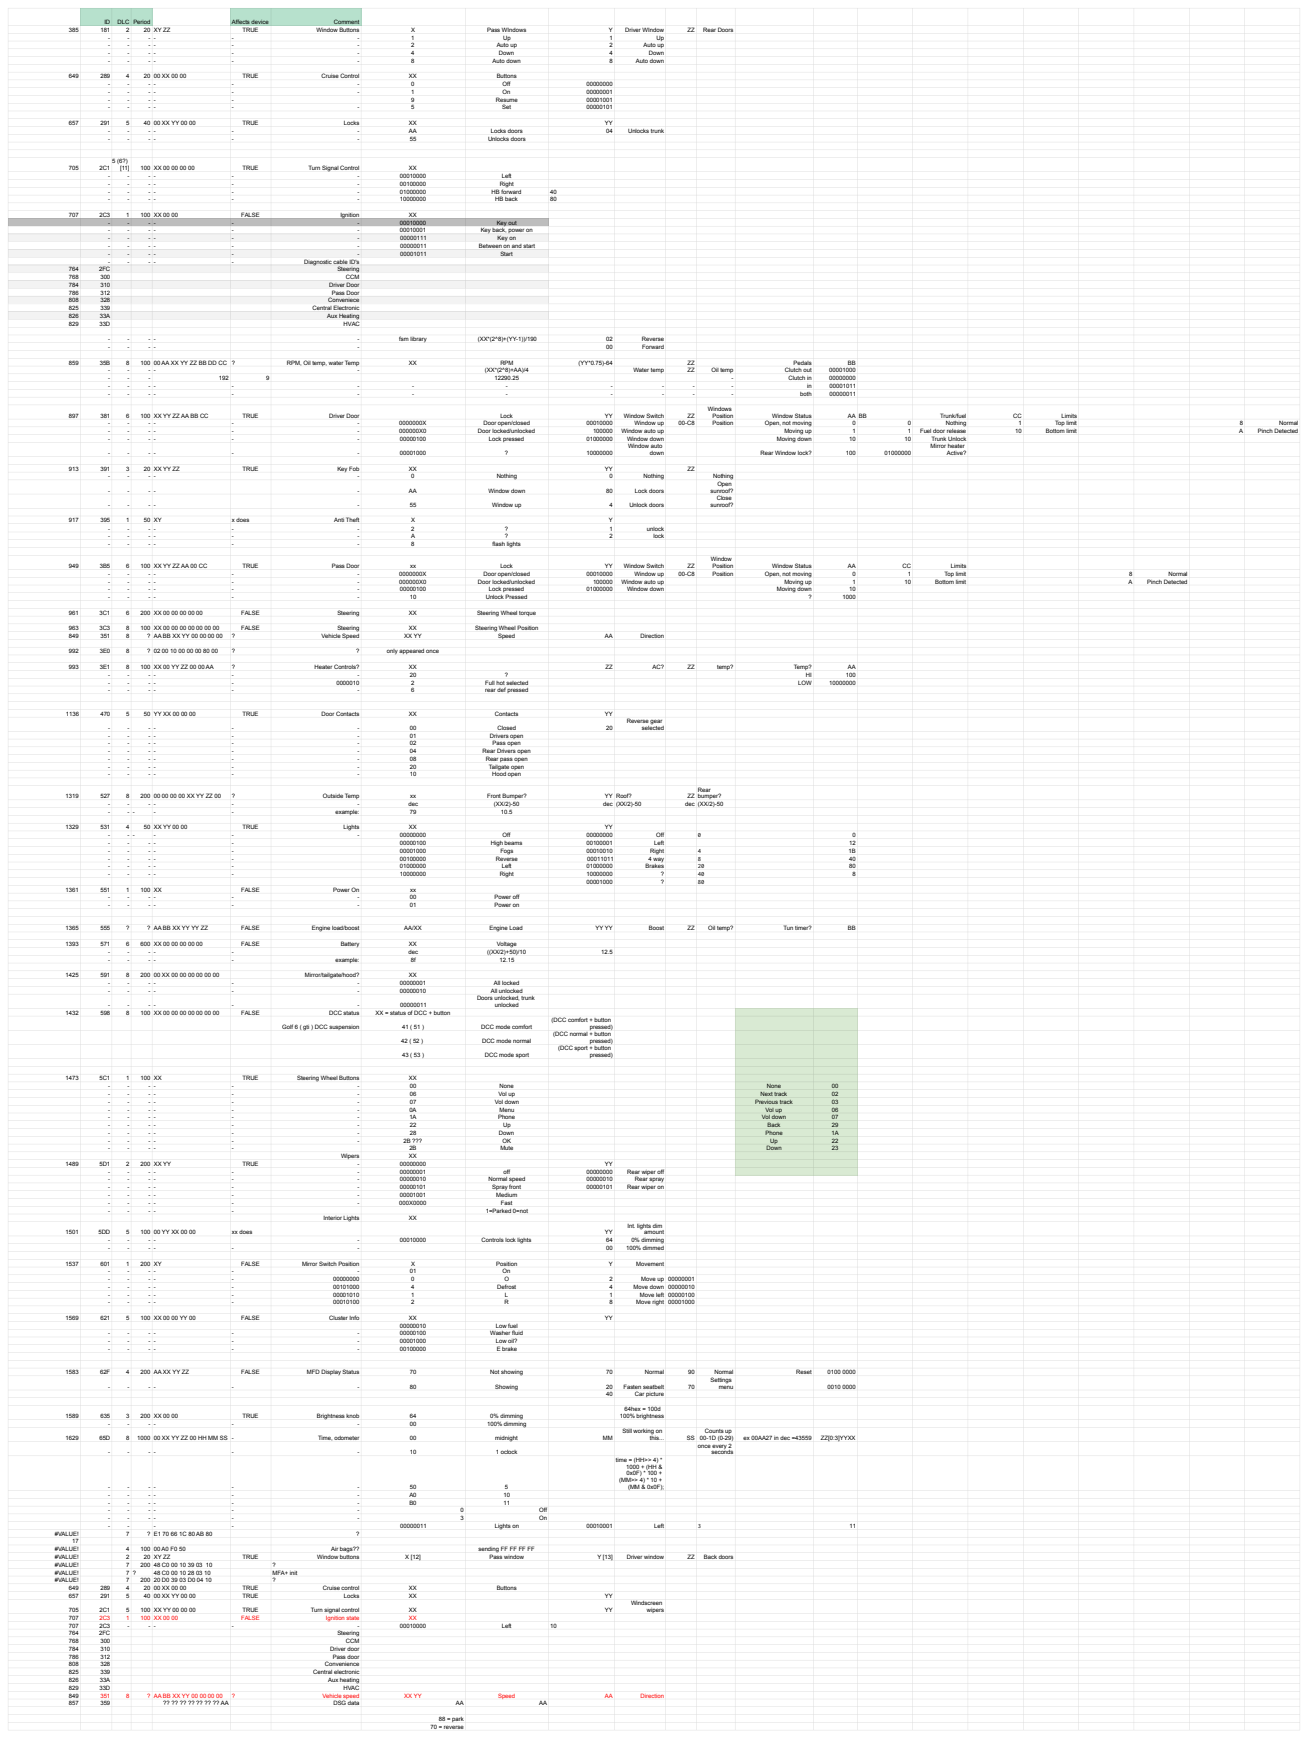
[picture p15: page 3]
DLC Period; Affects device; Comment 385; TRUE; Window Buttons; Pass WIndows; Driver WIndow; Rear Doors; Auto up; Down; Auto down; Cruise Control; Buttons; Off; Resume; Set; Locks; Locks doors; Unlocks trunk; Unlocks doors; Turn Signal Control; Left -; Right -; HB forward; HB back; FALSE; Ignition; Key out -; Key back, power on; Key on; Between on and start -; Start -; Diagnostic cable ID's 764; Steering; CCM; Driver Door 786; Pass Door 808; Conveniece; Central Electronic 826; Aux Heating; HVAC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

(DCC comfort + button pressed)

(DCC normal + button pressed)

(DCC sport + button pressed)

Still working on

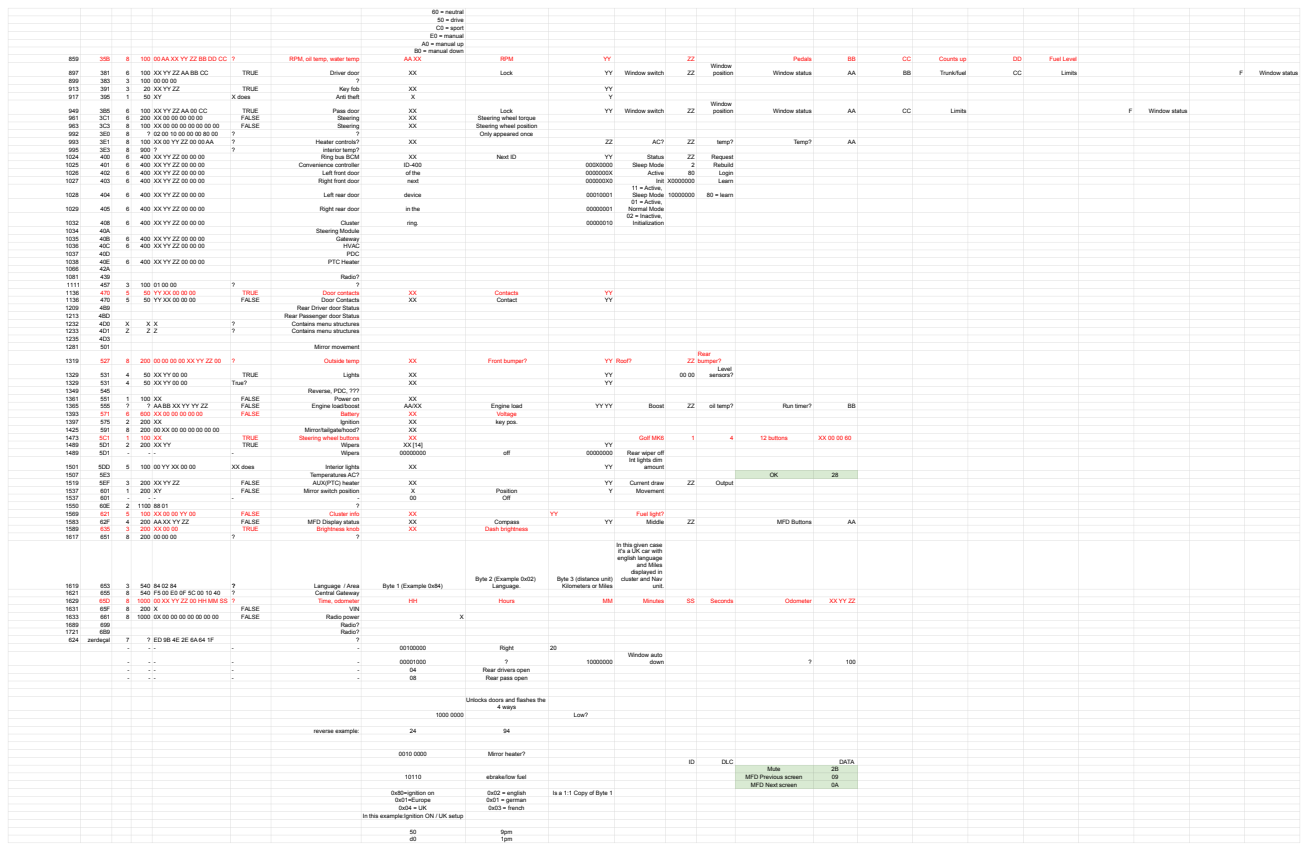
[picture p16: page 4]
RPM, oil temp, water temp; RPM; Pedals; Counts up; Fuel Level; TRUE; Driver door; Lock; Window switch; Window position; Window status; Trunk/fuel; Limits; Window status 899; Key fob; X does; Anti theft; Pass door; Window status 961; FALSE; Steering; Steering wheel torque; Steering wheel position; Only appeared once; Heater controls?; temp?; Temp?; interior temp?; Ring bus BCM; Next ID; Status; Request 1025; Convenience controller; Sleep Mode; Rebuild; Left front door; of the; Active; Login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

60 = neutral 50 = drive C0 = sport E0 = manual A0 = manual up B0 = manual down

01 = Active, Normal Mode

In this given case

In this example:Ignition ON / UK setup

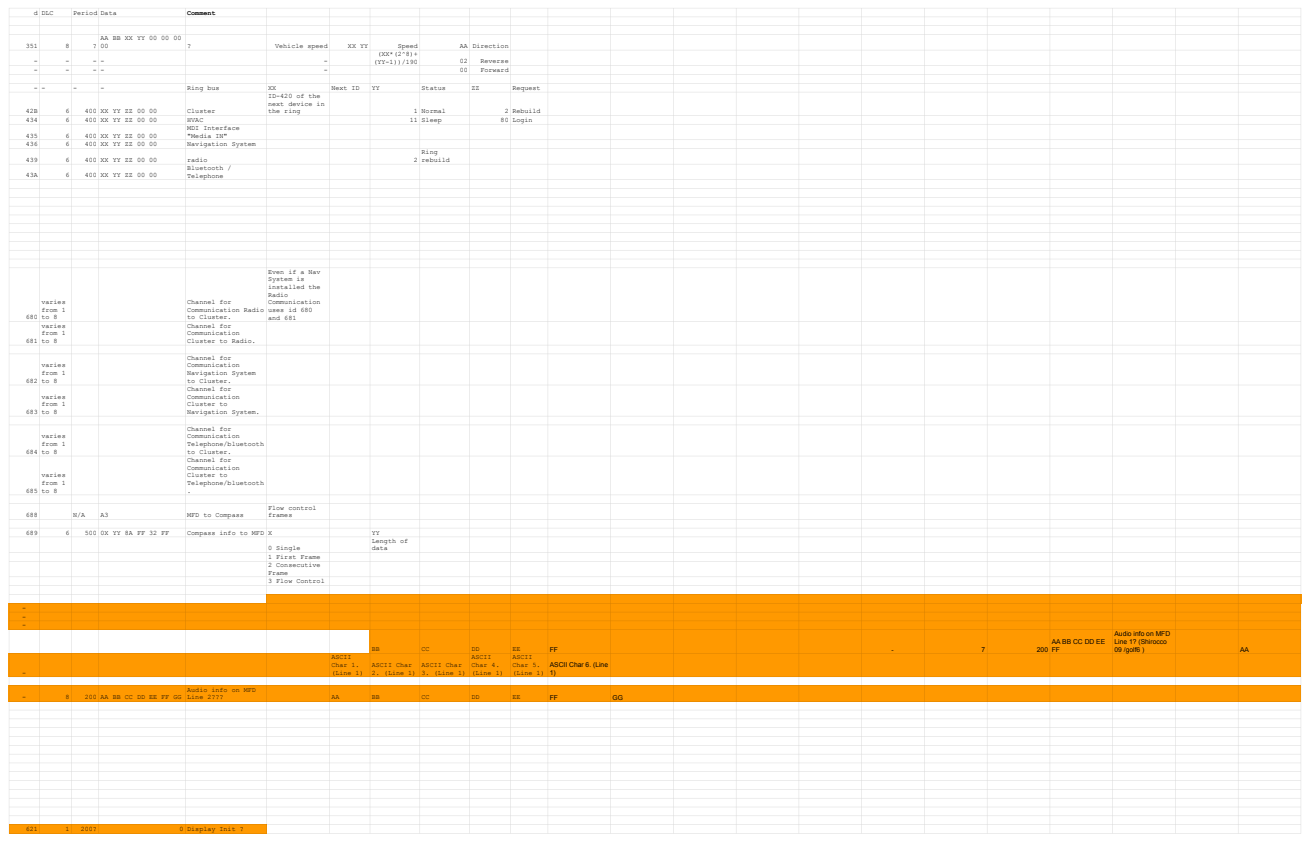
[picture p17: page 5]
d DLC; Period Data; Comment; Vehicle speed; Speed; AA Direction; Reverse; Forward; Ring bus; Next ID; Status; Request; Cluster; the ring; 1 Normal; 2 Rebuild; HVAC; 11 Sleep; 80 Login; MDI Interface "Media IN"; Navigation System; radio; Ring; rebuild; Bluetooth /; Telephone; varies; from 1; Channel for Communication; to Cluster.; Cluster to Navigation System.; Channel for Communication Telephone/bluetooth; Cluster to Telephone/bluetooth; MFD to Compass; Flow control; frames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

ID-420 of the
next device in

Even if a Nav
System is
installed the
Radio
Communication
uses id 680
and 681

Channel for
Communication Radio
to Cluster.
Cluster to Radio.

ASCII
(Line 1) ASCII Char 6. (Line 1)
Char 5.

Audio info on MFD

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

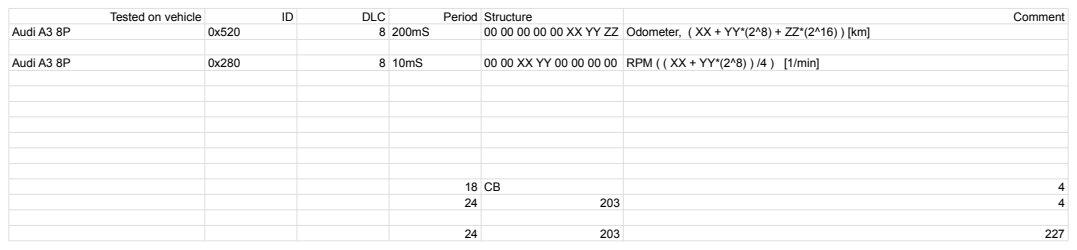
[picture p18: page 6]
Audi A3 8P; 00 00 XX YY 00 00 00 00 RPM ( ( XX + YY*(2^8) ) /4 ) [1/min]

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

60 6
70 7
80 8
90 9

A0 10 B0 11

http://cs.wikipedia.org/wiki/Volkswagen_Transport_Protocol

0C2 | ESP? | https://wiki.openstreetmap.org/wiki/VW-CAN
1A0 | ABS?
320
480 fuel? | Fuel level?

65Dh

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

http://www.volkspage.net/technik/ssp/ssp/SSP_238.pdf

[1] ID:

# Is the address on the CANBUS of the device sending the data (represented in hex)

# [2] DLC:

The 4-bit data length code (DLC) contains the number of bytes of data being transmitted (D0-Dx)

# [3] Dx/Bx Contains the data/byte being sent

# [4] Dx/Bx Contains the data/byte being sent

# [5] Dx/Bx Contains the data/byte being sent

# [6] Dx/Bx Contains the data/byte being sent

# [7] Dx/Bx Contains the data/byte being sent

# [8] Dx/Bx Contains the data/byte being sent

# [9] Dx/Bx Contains the data/byte being sent

# [10] Dx/Bx Contains the data/byte being sent

[11] not sure if 5 or 6 byte, Golf 6 seems to have 6 bytes, and I think Golf 5 has 5. Will check later
[12] 00010000=Up

# 00100000=Auto up 01000000=Down 10000000=Auto down

[13] 00000001=Up

# 00000010=Auto up 00000100=Down 00001000=Auto down

# [14] 0 Off 1 Normal 5 Medium 9 Fast
