callumrst/OpenHaldex-T4/(commit log)

2024-07-31 Update to standalone code
    Update to standalone code
    Open Frame (0xFF)
    5050 (0xA & 0x0)
2025-02-12 Enclosure
    Enclosure
    [HaldexBoxV3.STL, HaldexLidV3.STL]
2025-03-07 V1.09
    Removed low throttle lock.
2025-05-16 V1.10
    Added Gen2 Support - both standalone & OEM
    [Haldex Gen4 Read.xlsx, MKV GTI CAN-BUS data.xlsx, PQ35_46_ACAN_KMatrix_V5.20.6F_20160530_MH-1.xlsx]
2025-05-16 Added Teensy.exe
2025-09-01 Installation pins
    [Installation Pins (V3).xlsx]
2025-09-15 Change folder structure, remove Code folder and rename .ino to keep Arduino happy
